ManoDaSilva/mini_lpf/mini_lpf_pcb/mini_lpf_pcb.kicad_pcb

## KiCad design mini_lpf_pcb/mini_lpf_pcb.kicad_pcb (2026-10-13)

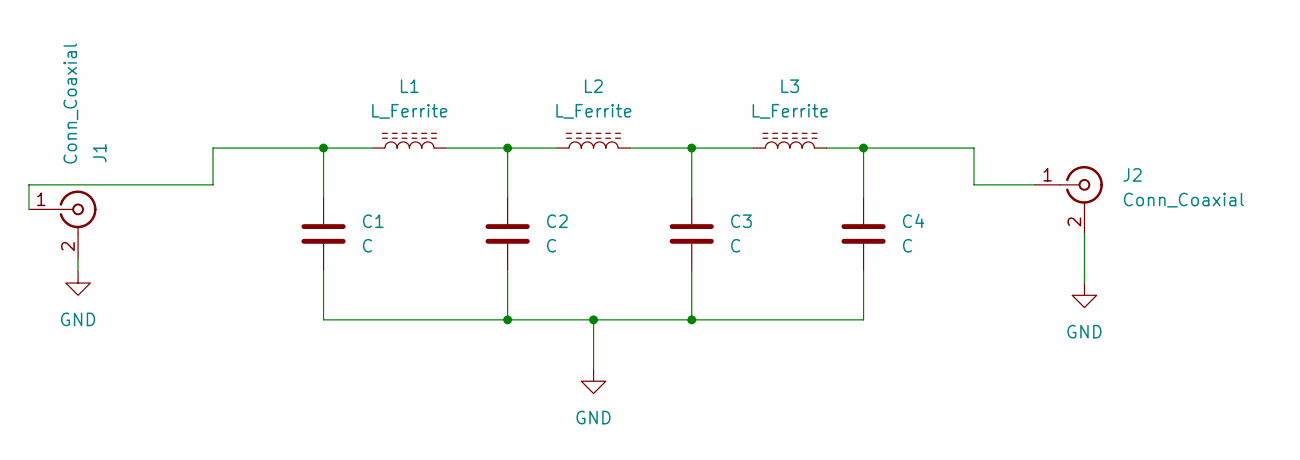
[picture p3: schematic mini_lpf_pcb.kicad_sch]

Parts:
C1, C2, C3, C4: C; C_Disc_D5.0mm_W2.5mm_P5.00mm
J1, J2: Conn_Coaxial; SMA_Samtec_SMA-J-P-H-ST-EM1_EdgeMount
L1, L2, L3: L_Ferrite; T37_vertical

Connections:
GND: C1.2, C2.2, C3.2, C4.2, J1.2 (Ext), J2.2 (Ext)
unnamed: C2.1, L1.2, L2.1
unnamed: C3.1, L2.2, L3.1
unnamed: C1.1, J1.1 (In), L1.1
unnamed: C4.1, J2.1 (In), L3.2

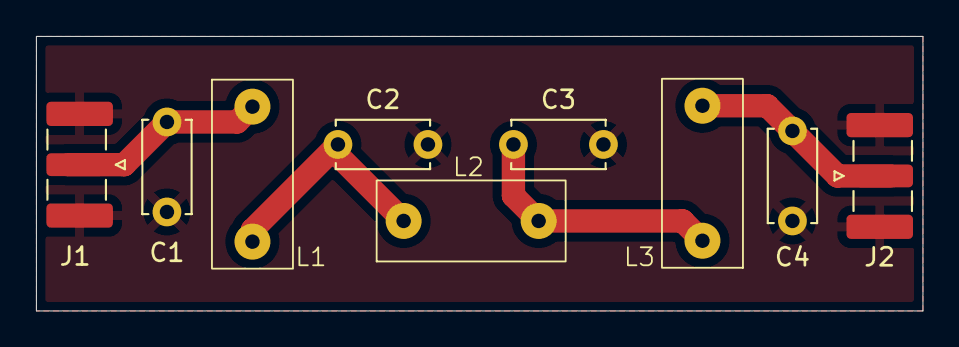
[picture p4: board mini_lpf_pcb.kicad_pcb from above]

Board: 2 copper layers, 49.2 x 15.2 mm, 9 parts (0 on the bottom side), 5 nets.
